bloodnok-marine/Graceful_PSU/kicad/GracefulPSU.pdf

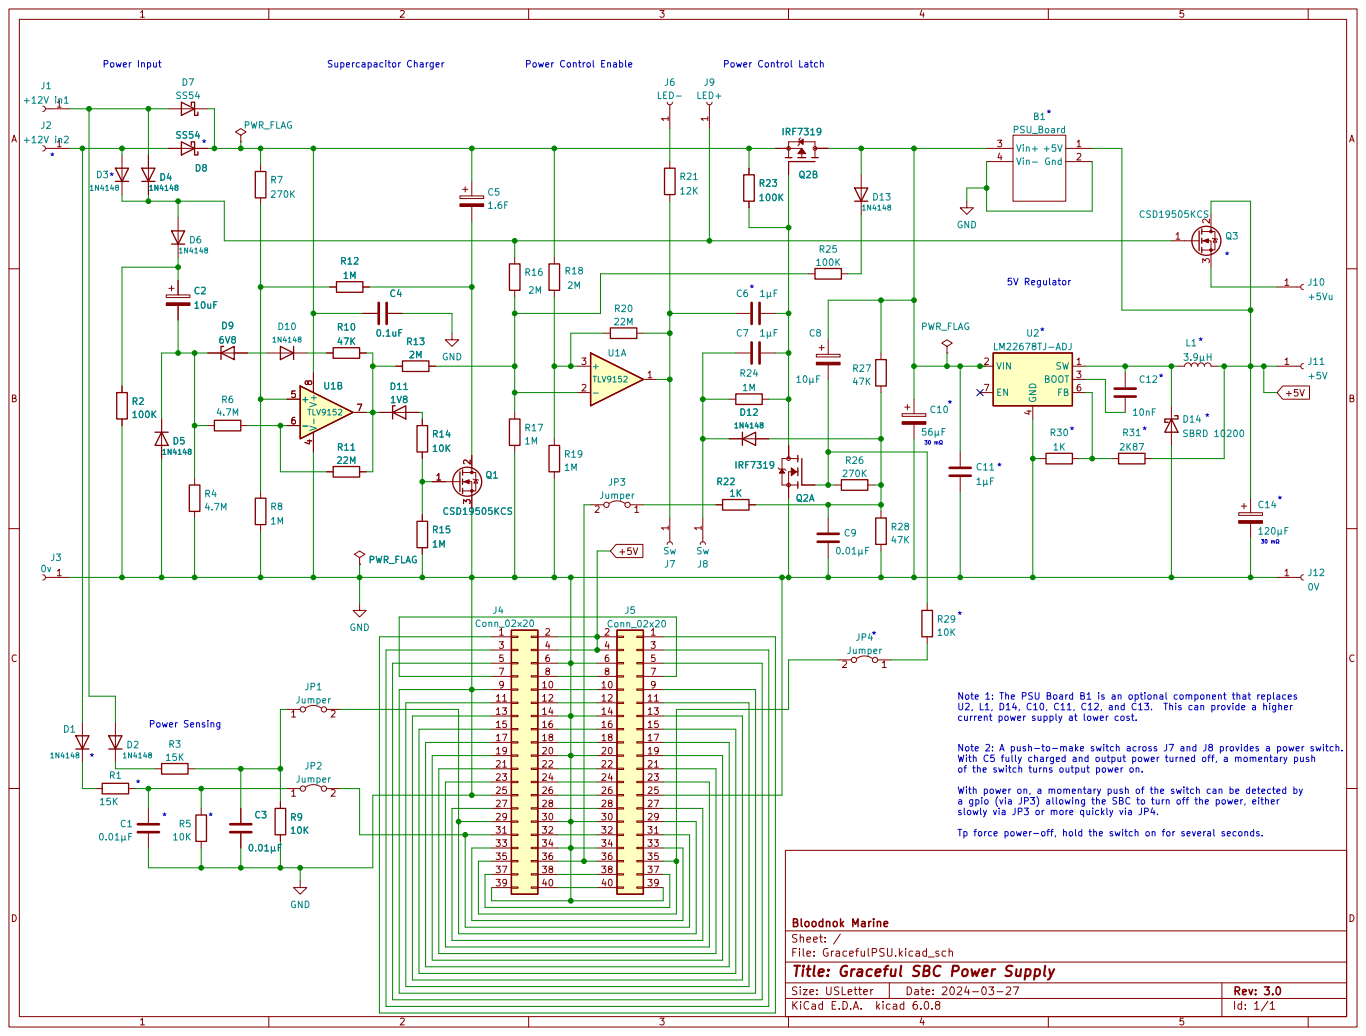
[picture p1: page 1]

0.1uF R12 1M 1M | IRF7319 R23 * | R25 | PWR_FLAG

* Note 1: The PSU Board B1 is an optional component that replaces

*Note 2: A push-to-make switch across J7 and J8 provides a power switch.

current power supply at lower cost. *
Jumper

9 | | 10 | | 10 | | 9
11 | | 12 | | 12 | | 11
13 | | 14
15 | | 16 | | 16 | | 15
17 | | 18 | | 18 | | 17
19 | | 20 | | 20 | | 19
21 | | 22 | | 22 | | 21
23 | | 24 | | 24 | | 23
25 | | 26 | | 26 | | 25
27 | | 28 | | 28 | | 27
29 | | 30 | | 30 | | 29
31 | | 32 | | 32 | | 31
33 | | 34 | | 34 | | 33
35 | | 36 | | 36 | | 35
37 | | 38 | 38 | | 37

U2, L1, D14, C10, C11, C12, and C13. This can provide a higher

With C5 fully charged and output power turned off, a momentary push
of the switch turns output power on.

With power on, a momentary push of the switch can be detected by
a gpio (via JP3) allowing the SBC to turn off the power, either
slowly via JP3 or more quickly via JP4.

Tp force power-off, hold the switch on for several seconds.

File: GracefulPSU.kicad_sch Sheet: / Bloodnok Marine

Id: 1/1 Title: Graceful SBC Power Supply
