bloodnok-marine/Graceful_PSU/kicad/schematic.pdf

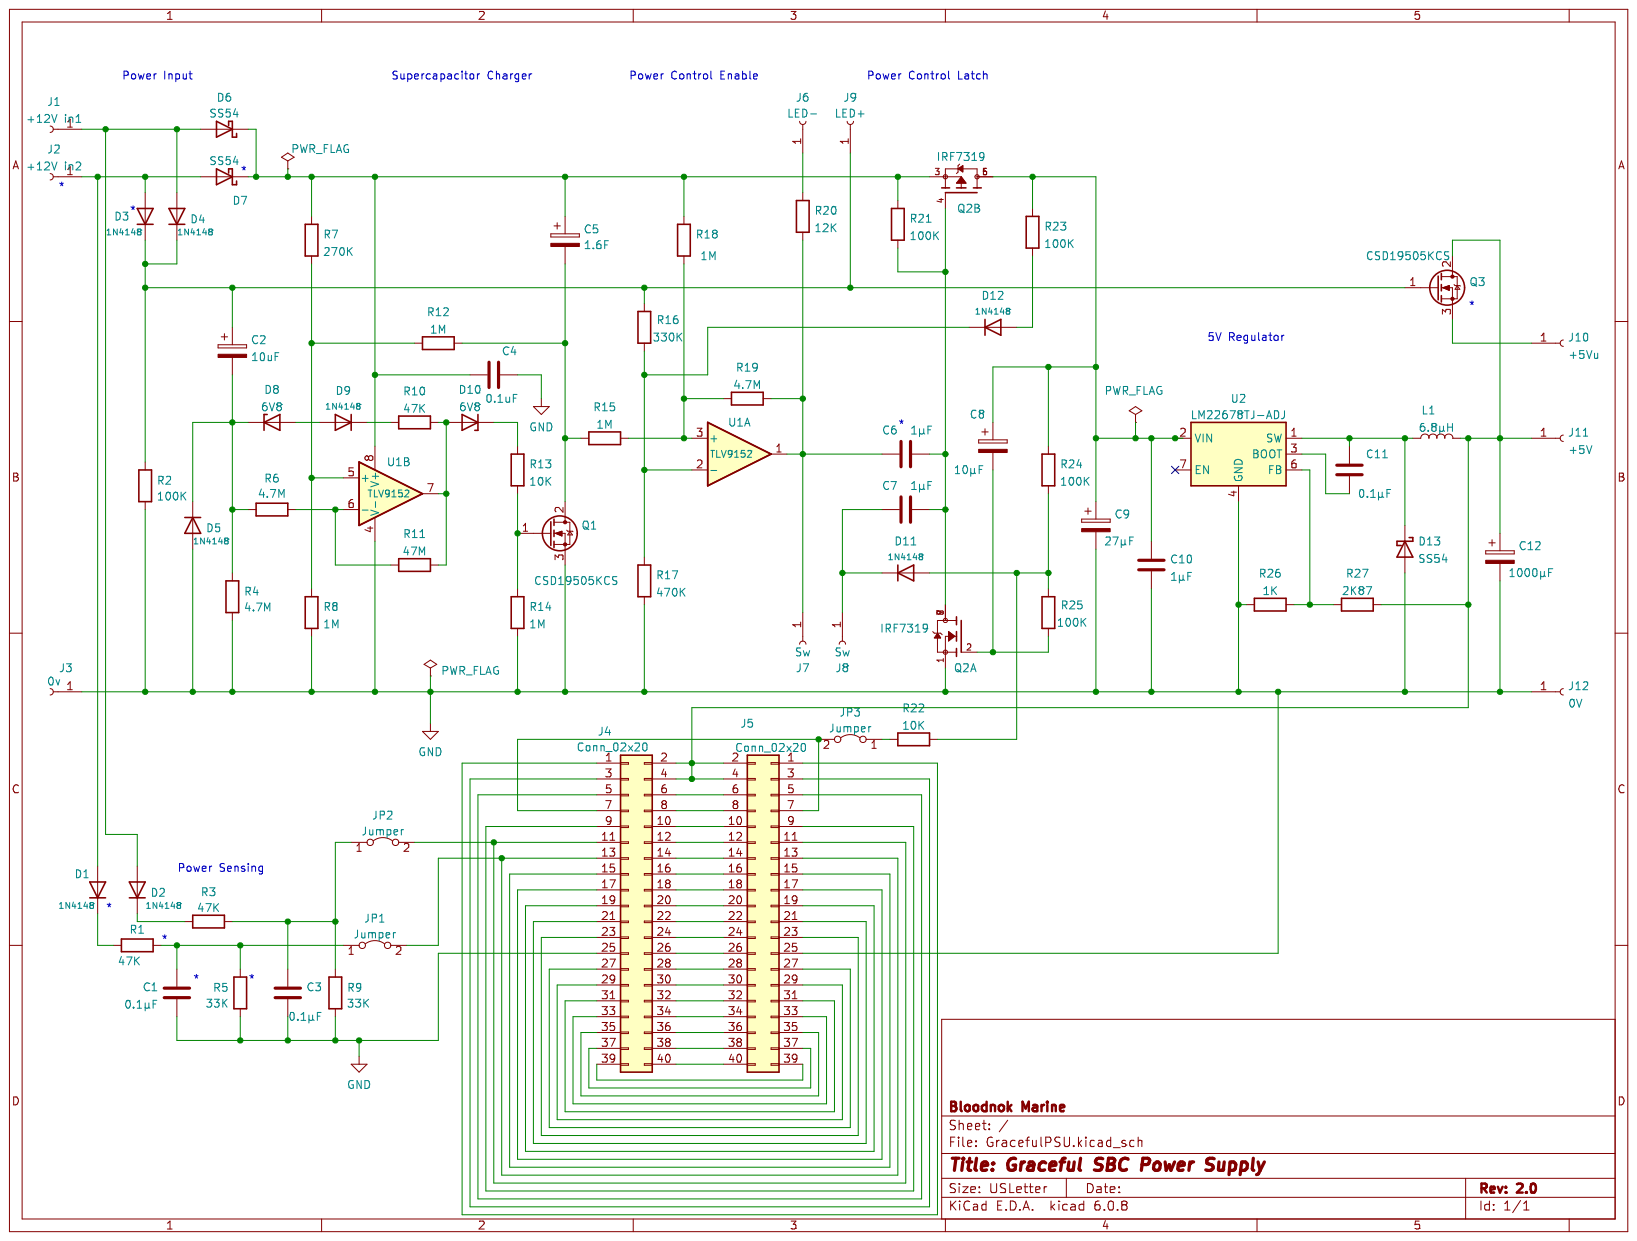
[picture p2: page 1]
