bloodnok-marine/Graceful_PSU/kicad/GracefulPSU.kicad_pcb

## KiCad design kicad/GracefulPSU.kicad_pcb (2024-03-27)

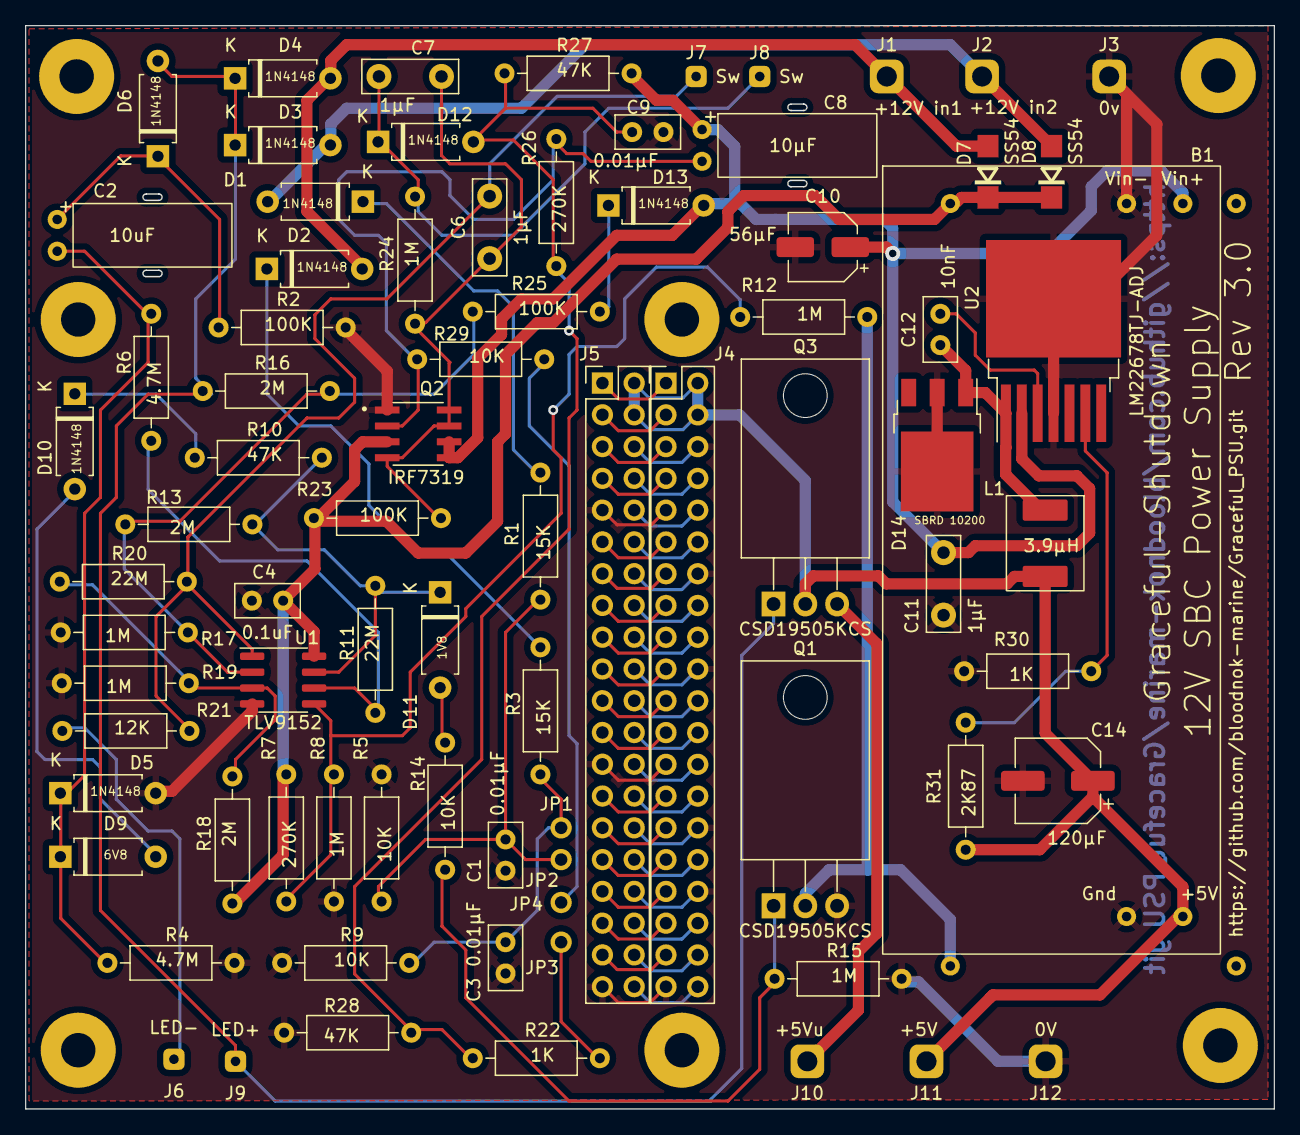
[picture p3: board GracefulPSU.kicad_pcb from above]

Board: 2 copper layers, 99.8 x 86.6 mm, 88 parts (1 on the bottom side), 66 nets.

Parts:
B1: PSU_Board; Buck Power Supply Board
C1, C3, C9: 0.01μF; C_Disc_D5.0mm_W2.5mm_P2.50mm
C2: 10uF; Capacitor_THT_HorizRadial_D5_P2_H12
C4: 0.1uF; C_Disc_D5.0mm_W2.5mm_P2.50mm
C5: 1.6F; SuperCapacitor Module
C6, C7, C11: 1μF; C_Disc_D7.5mm_W2.5mm_P5.00mm
C8: 10μF; Capacitor_THT_HorizRadial_D5_P2_H12
C10: 56μF; CP_Elec_5x5.3
C12: 10nF; C_Disc_D5.0mm_W2.5mm_P2.50mm
C14: 120μF; CP_Elec_6.3x5.9
D1, D2, D3, D4, D5, D6, D10, D12, D13: 1N4148; my_diode_7.62_h
D7, D8: SS54; DO-214AC
D9: 6V8; my_diode_7.62_h
D11: 1V8; my_diode_7.62_h
D14: SBRD 10200; TO-252-3_TabPin2
H1, H2, H8: (no value)
H3, H4, H5, H6: pihole
J1: +12V in1; SolderConnector - HighCurrent
J2: +12V in2; SolderConnector - HighCurrent
J3: 0v; SolderConnector - HighCurrent
J4, J5: Conn_02x20; PinHeader_2x20_P2.54mm_Vertical
J6: LED-; SolderConnector
J7, J8: Sw; SolderConnector
J9: LED+; SolderConnector
J10: +5Vu; SolderConnector - HighCurrent
J11: +5V; SolderConnector - HighCurrent
J12: 0V; SolderConnector - HighCurrent
JP1, JP2, JP3, JP4: Jumper; Half-Jumper
L1: 3.9μH; Shenzhen MWSA0604S
Q1, Q3: CSD19505KCS; TO-220-3_Horizontal_TabDown
Q2: IRF7319; SOIC127P600X175-8N
R1, R3: 15K; my_resistor_6.3_2.5_10.16
R2, R23, R25: 100K; my_resistor_6.3_2.5_10.16
R4, R6: 4.7M; my_resistor_6.3_2.5_10.16
R5, R9, R14, R29: 10K; my_resistor_6.3_2.5_10.16
R7, R26: 270K; my_resistor_6.3_2.5_10.16
R8, R12, R15, R17, R19, R24: 1M; my_resistor_6.3_2.5_10.16
R10, R27, R28: 47K; my_resistor_6.3_2.5_10.16
R11, R20: 22M; my_resistor_6.3_2.5_10.16
R13, R16, R18: 2M; my_resistor_6.3_2.5_10.16
R21: 12K; my_resistor_6.3_2.5_10.16
R22, R30: 1K; my_resistor_6.3_2.5_10.16
R31: 2K87; my_resistor_6.3_2.5_10.16
U1: TLV9152; SOIC-8_3.9x4.9mm_P1.27mm
U2: LM22678TJ-ADJ; TO-263-7_TabPin8

Connections:
+5V: B1.1 (+5V), C14.1, J4.2, J4.4, J5.2, J5.4, J11.1, L1.2, Q3.2 (D), R31.2
GND: B1.2 (Gnd), B1.4 (Vin-), C1.1, C3.2, C4.2, C9.2, C10.2, C11.2, C14.2, D5.2 (A), D14.2 (A), J3.1, J4.6, J4.9, J4.14, J4.20, J4.25, J4.30, J4.34, J4.39, J5.6, J5.9, J5.14, J5.20, J5.25, J5.30, J5.34, J5.39, J12.1, Q1.3 (S), Q2.1 (S1), R2.2, R4.2, R5.1, R8.2, R9.1, R15.2, R17.2, R19.2, R28.2, R30.2, U1.4 (V-), U2.4 (GND), U2.8 (GND)
unnamed: B1.3 (Vin+), C8.1, C10.1, C11.1, D13.2 (A), Q2.5 (D2), Q2.6 (D2), R27.2, U2.2 (VIN)
unnamed: C1.2, JP2.1 (A), R1.2, R5.2
unnamed: C2.1, D6.1 (K), R2.1
unnamed: C2.2, D5.1 (K), D9.1 (K), R4.1, R6.1
unnamed: C3.1, JP1.1 (A), R3.2, R9.2
unnamed: C4.1, C5.1, D7.1 (K), D8.1 (K), Q2.3 (S2), R7.1, R18.1, R23.1, U1.8 (V+)
unnamed: C5.2, Q1.2 (D), R12.2
unnamed: C6.1, C7.1, Q2.4 (G2), Q2.7 (D1), Q2.8 (D1), R23.2, R24.1
unnamed: C6.2, J7.1, R20.2, R21.2, U1.1
unnamed: C7.2, D12.1 (K), J8.1, R24.2
unnamed: C8.2, Q2.2 (G1), R26.1, R29.1
unnamed: C9.1, D12.2 (A), R22.1, R26.2, R27.1, R28.1
unnamed: C12.1, U2.3 (BOOT)
unnamed: C12.2, D14.1 (K), L1.1, U2.1 (SW)
unnamed: D1.1 (K), R1.1
unnamed: D1.2 (A), D3.2 (A), D8.2 (A), J2.1
unnamed: D2.1 (K), R3.1
unnamed: D2.2 (A), D4.2 (A), D7.2 (A), J1.1
unnamed: D3.1 (K), D4.1 (K), D6.2 (A), J9.1, Q3.1 (G), R16.1
unnamed: D10.1 (K), R10.1
unnamed: D9.2 (A), D10.2 (A)
unnamed: D11.1 (K), R10.2, R11.2, R13.1, U1.7
unnamed: D11.2 (A), R14.1
unnamed: D13.1 (K), R25.2
unnamed: J4.1, J5.1
unnamed: J4.3, J5.3
unnamed: J4.5, J5.5
unnamed: J4.7, J5.7
unnamed: J4.8, J5.8
unnamed: J4.10, J5.10
unnamed: J4.11, J5.11
unnamed: J4.12, J5.12
unnamed: J4.13, J5.13
unnamed: J4.15, J5.15
unnamed: J4.16, J5.16
unnamed: J4.17, J5.17
unnamed: J4.18, J5.18
unnamed: J4.19, J5.19
unnamed: J4.21, J5.21
unnamed: J4.22, J5.22
unnamed: J4.23, J5.23
unnamed: J4.24, J5.24
unnamed: J4.26, J5.26
unnamed: J4.27, J5.27
unnamed: J4.28, J5.28
unnamed: J4.29, J5.29
unnamed: J4.31, J5.31
unnamed: J4.32, J5.32
unnamed: J4.33, J5.33
unnamed: J4.35, J5.35
unnamed: J4.36, J5.36
unnamed: J4.37, J5.37
unnamed: J4.38, J5.38
unnamed: J4.40, J5.40
unnamed: J6.1, R21.1
unnamed: J10.1, Q3.3 (S)
unnamed: JP3.1 (A), R22.2
unnamed: JP4.1 (A), R29.2
unnamed: Q1.1 (G), R14.2, R15.1
unnamed: R6.2, R11.1, U1.6 (-)
unnamed: R7.2, R8.1, R12.1, U1.5 (+)
unnamed: R13.2, R16.2, R17.1, R25.1, U1.2 (-)
unnamed: R18.2, R19.1, R20.1, U1.3 (+)
unnamed: R30.1, R31.1, U2.6 (FB)
