bloodnok-marine/Graceful_PSU/(commit log)

2022-11-05 First release to github.
    [PSU-B_Cu.gbl, PSU-B_Mask.gbs, PSU-B_Paste.gbp, PSU-B_Silkscreen.gbo, PSU-Edge_Cuts.gm1, PSU-F_Cu.gtl, PSU-F_Mask.gts, PSU-F_Paste.gtp]
2022-11-05 Updated schematic in line with latest changes.
2022-11-06 Removed old, incorrect for this project, pcb gerber files.
    [PSU-B_Cu.gbl, PSU-B_Mask.gbs, PSU-B_Paste.gbp, PSU-B_Silkscreen.gbo, PSU-Edge_Cuts.gm1, PSU-F_Cu.gtl, PSU-F_Mask.gts, PSU-F_Paste.gtp]
2023-04-02 Initial release of revision 2. Fixes from prototyping and experiments.
    [GracefulPSU.kicad_pcb, GracefulPSU.kicad_sch, PSU.kicad_pcb, PSU.kicad_sch]
2023-11-12 Release of version sent for pcb manufacture.
    [GracefulPSU-B_Cu.gbr, GracefulPSU-B_Mask.gbr, GracefulPSU-B_Paste.gbr, GracefulPSU-B_Silkscreen.gbr, GracefulPSU-Edge_Cuts.gbr, GracefulPSU-F_Cu.gbr, GracefulPSU-F_Mask.gbr, GracefulPSU-F_Paste.gbr]
2024-03-26 Prep for release to github.
    [GracefulPSU.kicad_pcb, GracefulPSU.kicad_sch, simulation.kicad_sch]
2024-03-27 Preparing for release to github.
    [GracefulPSU-B_Cu.gbr, GracefulPSU-B_Mask.gbr, GracefulPSU-B_Paste.gbr, GracefulPSU-B_Silkscreen.gbr, GracefulPSU-Edge_Cuts.gbr, GracefulPSU-F_Cu.gbr, GracefulPSU-F_Mask.gbr, GracefulPSU-F_Paste.gbr]
2024-03-27 Prep to send R3.0 board to the manufacturer.
    [GracefulPSU-B_Cu.gbr, GracefulPSU-B_Mask.gbr, GracefulPSU-B_Paste.gbr, GracefulPSU-B_Silkscreen.gbr, GracefulPSU-Edge_Cuts.gbr, GracefulPSU-F_Cu.gbr, GracefulPSU-F_Mask.gbr, GracefulPSU-F_Paste.gbr]
